k-rush/nixie/Nixie_Controller_BOM.xlsx

Sheet: Controller
Qty | Parts | Description | MANUFACTURER_NAME | MANUFACTURER_PART_NUMBER | Digikey PN | Digikey link | MOUSER_PART_NUMBER | MOUSER_PRICE-STOCK
2 | FTDI, SV2 | PIN HEADER | Preci-Dip | 801-87-005-10-005101 | 1212-1184-ND | https://www.digikey.com/product-detail/en/preci-dip/801-87-005-10-005101/1212-1184-ND/3757434
2 | C3, C4 | CAPACITOR, American symbol | AVX Corporation | SR215C103KAATR1 | 478-11035-1-ND | https://www.digikey.com/product-detail/en/avx-corporation/SR215C103KAATR1/478-11035-1-ND/7536147
1 | C5 | POLARIZED CAPACITOR, American symbol | Würth Elektronik | 860020672001- | 732-8847-3-ND | https://www.digikey.com/product-detail/en/w-rth-elektronik/860020672001/732-8847-3-ND/5727084
1 | RSENSE | RESISTOR, European symbol | Panasonic | ERJ-L1WKF50MU | P50MCT-ND | https://www.digikey.com/product-detail/en/panasonic-electronic-components/ERJ-L1WKF50MU/P50MCT-ND/272513
2 | C9, C11 | CAPACITOR, European symbol | AVX Corporation | 08055G104ZAT2A | 478-1421-1-ND | https://www.digikey.com/product-detail/en/avx-corporation/08055G104ZAT2A/478-1421-1-ND/564453
1 | C13 |  | Panasonic | ECW-U2104V16 | PCF1412CT-ND | https://www.digikey.com/product-detail/en/panasonic-electronic-components/ECW-U2104V16/PCF1412CT-ND/431748
1 | C10 | Capacitor, Tantalum, EU 7343 case, polarised | AVX Corporation | TPSD106K035R0300 | 478-1775-1-ND | https://www.digikey.com/product-detail/en/avx-corporation/TPSD106K035R0300/478-1775-1-ND/564807
1 | L1 | SMT power inductors | TDK Electronics Inc. | B82479A1104M000 | 495-2703-1-ND | https://www.digikey.com/product-detail/en/tdk-electronics-inc/B82479A1104M000/495-2703-1-ND/1243644
1 | R10 | RESISTOR, European symbol | Yageo | AC0805FR-0710KL | 311-10KLGCT-ND | https://www.digikey.com/product-detail/en/yageo/AC0805FR-0710KL/311-10KLGCT-ND/2828155
1 | R11 | RESISTOR, American symbol | Yageo | AC0805FR-0710KL | 311-10KLGCT-ND | https://www.digikey.com/product-detail/en/yageo/AC0805FR-0710KL/311-10KLGCT-ND/2828156
6 | R3, R4, R5, R6, R7, R8 | RESISTOR, American symbol | Vishay BC Components | MBB02070C1002FRP00 | BC10.0KZTR-ND | https://www.digikey.com/product-detail/en/vishay-bc-components/MBB02070C1002FRP00/BC10.0KZTR-ND/338172
1 | C14 | Capacitor, Tantalum, EU 7343 case, polarised | AVX Corporation | TPSD107M020R0085 | 478-6066-1-ND | https://www.digikey.com/product-detail/en/avx-corporation/TPSD107M020R0085/478-6066-1-ND/2208975
2 | C1, C2 | POLARIZED CAPACITOR, American symbol | Panasonic | ECE-A1HKA100I | P19476TB-ND | https://www.digikey.com/product-detail/en/panasonic-electronic-components/ECE-A1HKA100I/P19476TB-ND/6362773
1 | Q1 | CRYSTAL | ECS Inc. | ECS-160-20-4X-DU | XC1925-ND | https://www.digikey.com/product-detail/en/ECS-160-20-4X-DU/XC1925-ND/2781930/?itemSeq=315959394
1 | R9 | RESISTOR, European symbol | Panasonic | ERJ-1TYJ155U | PT1.5MXCT-ND | https://www.digikey.com/product-detail/en/panasonic-electronic-components/ERJ-1TYJ155U/PT1.5MXCT-ND/365327
1 | C8 | POLARIZED CAPACITOR, American symbol | Würth Elektronik | 860020672005- | 732-8851-1-ND | https://www.digikey.com/product-detail/en/w-rth-elektronik/860020672005/732-8851-1-ND/5728796
2 | R1, R2 | RESISTOR, American symbol | Vishay BC Components | MBB02070C2201FCT00 | BC3668CT-ND | https://www.digikey.com/product-detail/en/vishay-bc-components/MBB02070C2201FCT00/BC3668CT-ND/7351098
2 | C6, C7 | CAPACITOR, American symbol | AVX Corporation | SR211A200JAR | 478-11707-ND | https://www.digikey.com/product-detail/en/avx-corporation/SR211A200JAR/478-11707-ND/3065643
1 | X1 | .100 (2.54mm) Center Header - 2 Pin" | Preci-Dip | 801-87-002-10-001101 | 1212-1179-ND | https://www.digikey.com/product-detail/en/preci-dip/801-87-002-10-001101/1212-1179-ND/3757429
1 | Y2 | 32.768kHz Crystal | EPSON | C-002RX 32.7680K-E:PBFREE | SER3205-ND | https://www.digikey.com/product-detail/en/C-002RX+32.7680K-E%3aPBFREE/SER3205-ND/1022093/?itemSeq=315961191
1 | U1 | Atmel 328P | Microchip Technology | ATMEGA328P-PU | ATMEGA328P-PU-ND | https://www.digikey.com/product-detail/en/microchip-technology/ATMEGA328P-PU/ATMEGA328P-PU-ND/1914589
1 | C12 | Capacitor, Tantalum, EU 7343 case, polarised | Panasonic Electronic Components | EEV-EB2E100Q | PCE3432CT-ND | https://www.digikey.com/product-detail/en/panasonic-electronic-components/EEV-EB2E100Q/PCE3432CT-ND/361774
1 | VR1 |  | Bourns Inc. | 3214W-1-502E | 3214W-502ECT-ND | https://www.digikey.com/product-detail/en/3214W-1-502E/3214W-502ECT-ND/248448/?itemSeq=315962998
1 | IC3 | Positive VOLTAGE REGULATOR | STMicroelectronics | L7805CV | 497-1443-5-ND | https://www.digikey.com/product-detail/en/stmicroelectronics/L7805CV/497-1443-5-ND/585964
1 | S2 | Toggle Switch SPDT On-None-On, 100 mA, PCB | NKK Switches | A12AV | 360-3741-ND | https://www.digikey.com/product-detail/en/nkk-switches/A12AV/360-3741-ND/1058571 | 633-A12AV | https://www.mouser.com/Search/Refine.aspx?Keyword=633-A12AV
1 | J1 | DC Power Connectors Power Jack/Connector 2.1mm x 5.5mm | CUI Devices | PJ-102A | CP-102A-ND | https://www.digikey.com/product-detail/en/cui-devices/PJ-102A/CP-102A-ND/275425
1 | IC1 | DS1307 | Maxim Integrated | DS1307+ | DS1307+-ND | https://www.digikey.com/product-detail/en/maxim-integrated/DS1307/DS1307-ND/956883
1 | D1 | DIODE | Vishay Semiconductor Diodes Division | ES2F-E3/52T | ES2F-E3/52TGITR-ND | https://www.digikey.com/products/en?keywords=ES2F-E3%2F52TGITR-ND%09
1 | U2 | BATTERY HOLDER COIN 20MM PC PIN | TE Connectivity AMP Connectors | 120591-1 | A99328-ND | https://www.digikey.com/product-detail/en/120591-1/A99328-ND/289426/?itemSeq=315972113
1 | T1 | N-CHANNEL MOS FET | Vishay Siliconix | IRF644PBF | IRF644PBF-ND | https://www.digikey.com/product-detail/en/vishay-siliconix/IRF644PBF/IRF644PBF-ND/812069
1 | IC2 |  | Maxim Integrated | MAX1771ESA+ | MAX1771ESA+-ND | https://www.digikey.com/product-detail/en/maxim-integrated/MAX1771ESA-/MAX1771ESA--ND/947783
1 | VR2 | Encoders 12PPR 24Detents 5V 2bit GrayCodeFlatted | Bourns | PEC09-2220F-S0012 | PEC09-2220F-S0012-ND | https://www.digikey.com/products/en?keywords=PEC09-2220F-S0012 | 652-PEC092220FS0012 | https://www.mouser.com/Search/Refine.aspx?Keyword=652-PEC092220FS0012

Sheet: Display IN14
Qty | Value | Device | Package | Parts | Description | MANUFACTURER_NAME | MANUFACTURER_PART_NUMBER | Digikey PN | Digikey link
4 |  | LED3MM | LED3MM | LED1, LED2, LED3, LED4 | LED BLUE CLEAR 3MM T/H | Inolux | INL-3AB30 | 1830-1005-ND | https://www.digikey.com/product-detail/en/inolux/INL-3AB30/1830-1005-ND/7604618
1 |  | MA05-1 | MA05-1 | SV1 | PIN HEADER | Preci-Dip | 801-87-005-10-005101 | 1212-1184-ND | https://www.digikey.com/product-detail/en/preci-dip/801-87-005-10-005101/1212-1184-ND/3757434
4 | 15k | R-US_R0805 | R0805 | R3, R4, R5, R6 | RESISTOR, American symbol | Panasonic Electronic Components | ERJ-P06J153V | P15KADCT-ND | https://www.digikey.com/product-detail/en/panasonic-electronic-components/ERJ-P06J153V/P15KADCT-ND/525459
1 | 22-23-2021 | 22-23-2021 | 22-23-2021 | X1 | .100 (2.54mm) Center Header - 2 Pin" | Preci-Dip | 801-87-002-10-001101 | 1212-1179-ND | https://www.digikey.com/product-detail/en/preci-dip/801-87-002-10-001101/1212-1179-ND/3757429
1 | 330 | R-US_R0805 | R0805 | R1 | RESISTOR, American symbol | TE Connectivity Passive Product | CRGCQ0805F330R | A129743CT-ND | https://www.digikey.com/product-detail/en/te-connectivity-passive-product/CRGCQ0805F330R/A129743CT-ND/8577575
1 | 68k | R-US_R0805 | R0805 | R2 | RESISTOR, American symbol | Panasonic Electronic Components | ERJ-PB6B6802V | P20803CT-ND | https://www.digikey.com/product-detail/en/panasonic-electronic-components/ERJ-PB6B6802V/P20803CT-ND/6215058
4 | IN-14 | IN-14 | IN-14 | N1, N2, N3, N4 | IN-14: medium numeric frontview nixie tube
1 | IN-3 | IN-3 | IN-3 | N5 | IN-3: nixie bulb
5 | TPIC6B595DWRG4 | TPIC6B595DWRG4 | DW20 | U1, U2, U3, U4, U5 |  | Texas Instruments | TPIC6B595DWRG4 | 296-26898-1-ND | https://www.digikey.com/product-detail/en/texas-instruments/TPIC6B595DWRG4/296-26898-1-ND/2255207
