k-rush/nixie/(list of files, cad)

Other CAD files:
Fusion/Nixie_Controller.f3d
