k-rush/nixie/Nixie_Contoller/nixie_controller.brd

## EAGLE design Nixie_Contoller/nixie_controller.brd (2020-02-24)

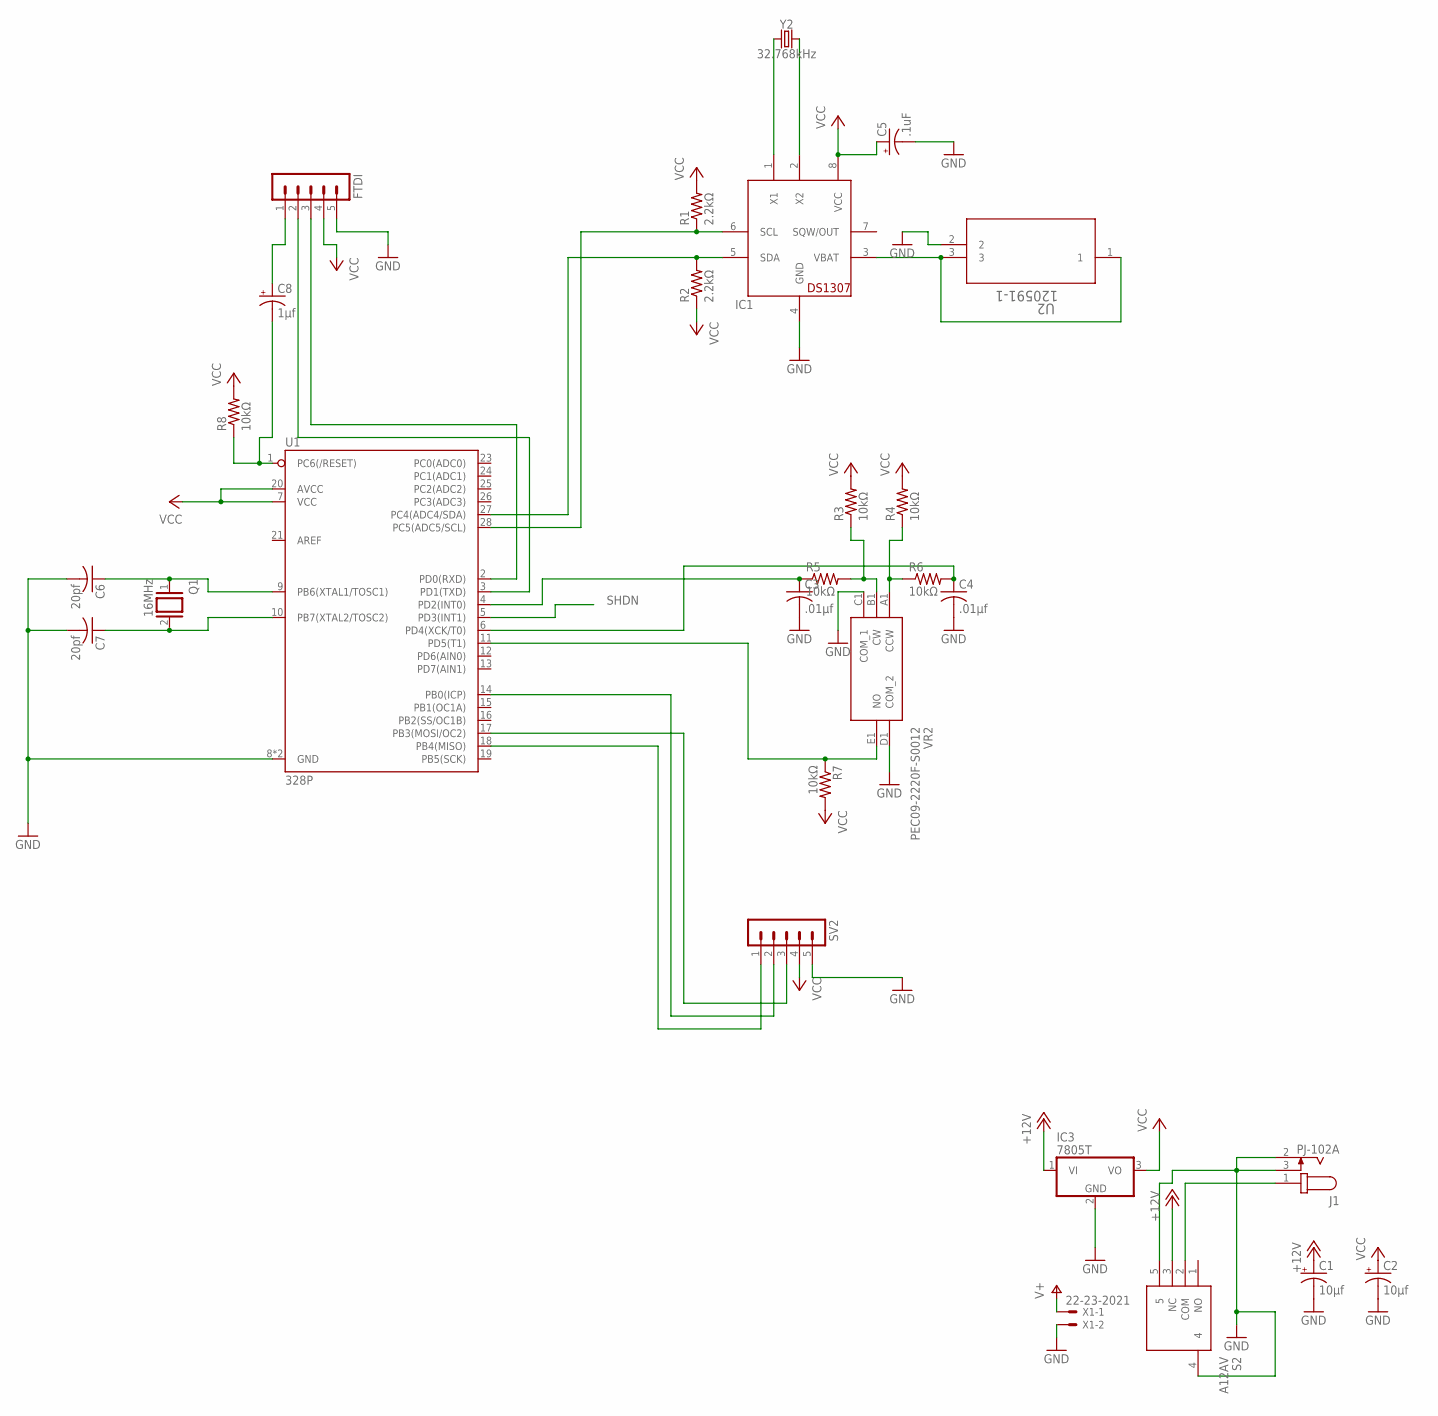
[picture p1: schematic nixie_controller.sch, sheet 1]

Parts:
C1, C2: 10μf; E2-5
C3, C4: .01μf; C050-030X075
C5: .1uF; E2-5
C6, C7: 20pf; C050-030X075
C8: 1μf; E2-5
FTDI: MA05-1
IC1: DS1307; DIL08
IC3: 7805T; TO220H
J1: PJ-102A; CUI_PJ-102A
Q1: 16MHz; QS
R1, R2: 2.2kΩ; 0207/10
R3, R4, R5, R6, R7, R8: 10kΩ; 0207/10
S2: A12AV
SV2: MA05-1
U1: 328P; DIP28
U2: 120591-1; CONN3_120591-1
VR2: PEC09-2220F-S0012; PEC092220FS0012
X1: 22-23-2021
Y2: 32.768kHz; CRYSTAL-PTH-2X6-CYL

Connections:
+12V: C1.+, IC3.1 (VI), S2.3 (NC); also elsewhere on the board
CLK: SV2.1, U1.18 (PB4(MISO))
GND: C1.-, C2.-, C3.2, C4.2, C5.-, C6.2, C7.2, FTDI.5, IC1.4 (GND), IC3.2 (GND), J1.2, J1.3, S2.4, S2.5, SV2.5, U1.8 (GND), U1.22 (GND), U2.2, VR2.C1 (COM_1), VR2.D1 (COM_2), X1.2; also elsewhere on the board
unnamed: IC1.3 (VBAT), U2.1, U2.3
unnamed: R7.1, U1.11 (PD5(T1)), VR2.E1 (NO)
unnamed: R4.1, R6.1, VR2.A1 (CCW)
unnamed: IC1.1 (X1), Y2.1
unnamed: IC1.2 (X2), Y2.2
unnamed: J1.1, S2.2 (COM)
unnamed: SV2.2, U1.14 (PB0(ICP))
unnamed: C3.1, R5.1, U1.4 (PD2(INT0))
unnamed: C4.1, R6.2, U1.6 (PD4(XCK/T0))
unnamed: C6.1, Q1.1, U1.9 (PB6(XTAL1/TOSC1))
unnamed: IC1.6 (SCL), R1.1, U1.28 (PC5(ADC5/SCL))
unnamed: IC1.5 (SDA), R2.2, U1.27 (PC4(ADC4/SDA))
unnamed: C8.-, R8.1, U1.1 (PC6(/RESET))
unnamed: R3.1, R5.2, VR2.B1 (CW)
unnamed: C7.1, Q1.2, U1.10 (PB7(XTAL2/TOSC2))
unnamed: C8.+, FTDI.1
unnamed: SV2.3, U1.17 (PB3(MOSI/OC2))
unnamed: FTDI.2, U1.3 (PD1(TXD))
unnamed: FTDI.3, U1.2 (PD0(RXD))
SHDN: U1.5 (PD3(INT1)); also elsewhere on the board
V+: X1.1; also elsewhere on the board
VCC: C2.+, C5.+, FTDI.4, IC1.8 (VCC), IC3.3 (VO), R1.2, R2.1, R3.2, R4.2, R7.2, R8.2, SV2.4, U1.7 (VCC), U1.20 (AVCC)

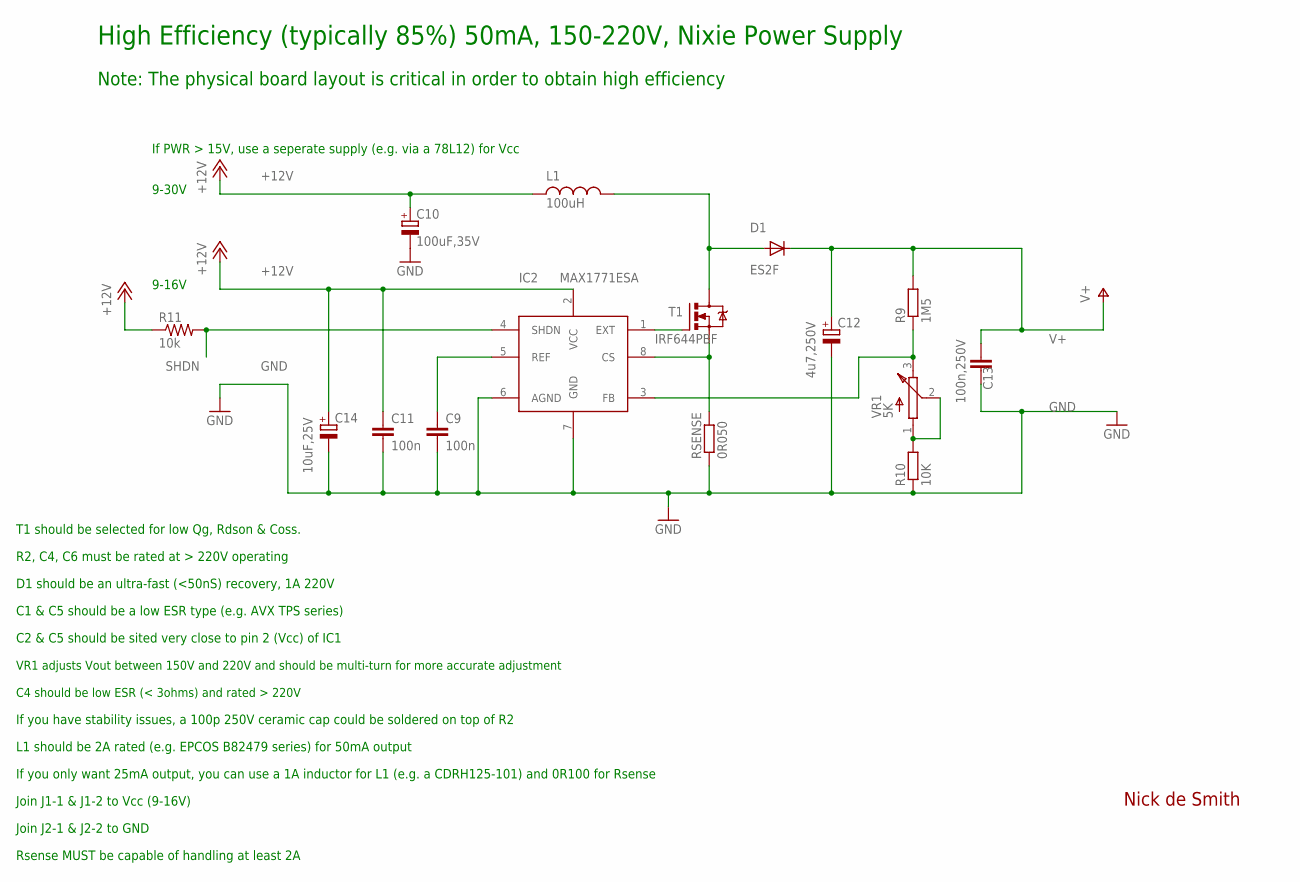
[picture p2: schematic nixie_controller.sch, sheet 2]

Parts:
C9, C11: 100n; C0805
C10: 100uF,35V; C-EIA-7343
C12: 4u7,250V; NICHICON-UJ-12
C13: 100n,250V; C2420
C14: 10uF,25V; C-EIA-7343
D1: ES2F; SMC
IC2: MAX1771ESA; SO-8
L1: 100uH; L-B82479
R9: 1M5; R2512
R10: 10K; R0805
R11: 10k; M0805
RSENSE: 0R050; R2010
T1: IRF644PBF; TO220BV
VR1: 5K; BOURNS-3214W

Connections:
+12V: C10.+, C11.1, C14.+, IC2.2 (VCC), L1.P$1 (1), R11.1; also elsewhere on the board
EXT: IC2.1 (EXT), T1.G
GND: C9.2, C10.-, C11.2, C12.1 (-), C13.P$2 (2), C14.-, IC2.6 (AGND), IC2.7 (GND), R10.1, RSENSE.1; also elsewhere on the board
unnamed: IC2.3 (FB), R9.1, VR1.3 (B)
unnamed: D1.A, L1.P$2 (2), T1.D
unnamed: C9.1, IC2.5 (REF)
unnamed: R10.2, VR1.1 (A), VR1.2 (W)
unnamed: IC2.8 (CS), RSENSE.2, T1.S
SHDN: IC2.4 (SHDN), R11.2; also elsewhere on the board
V+: C12.2 (+), C13.P$1 (1), D1.C, R9.2; also elsewhere on the board

Notes on the sheet:
R2, C4, C6 must be rated at > 220V operating
D1 should be an ultra-fast (<50nS) recovery, 1A 220V
C1 & C5 should be a low ESR type (e.g. AVX TPS series)
C2 & C5 should be sited very close to pin 2 (Vcc) of IC1
Nick de Smith
VR1 adjusts Vout between 150V and 220V and should be multi-turn for more accurate adjustment
C4 should be low ESR (< 3ohms) and rated > 220V
If you have stability issues, a 100p 250V ceramic cap could be soldered on top of R2
L1 should be 2A rated (e.g. EPCOS B82479 series) for 50mA output
Join J1-1 & J1-2 to Vcc (9-16V)
Join J2-1 & J2-2 to GND
T1 should be selected for low Qg, Rdson & Coss.
Rsense MUST be capable of handling at least 2A
High Efficiency (typically 85%) 50mA, 150-220V, Nixie Power Supply
9-16V
9-30V
If PWR > 15V, use a seperate supply (e.g. via a 78L12) for Vcc
Note: The physical board layout is critical in order to obtain high efficiency
If you only want 25mA output, you can use a 1A inductor for L1 (e.g. a CDRH125-101) and 0R100 for Rsense

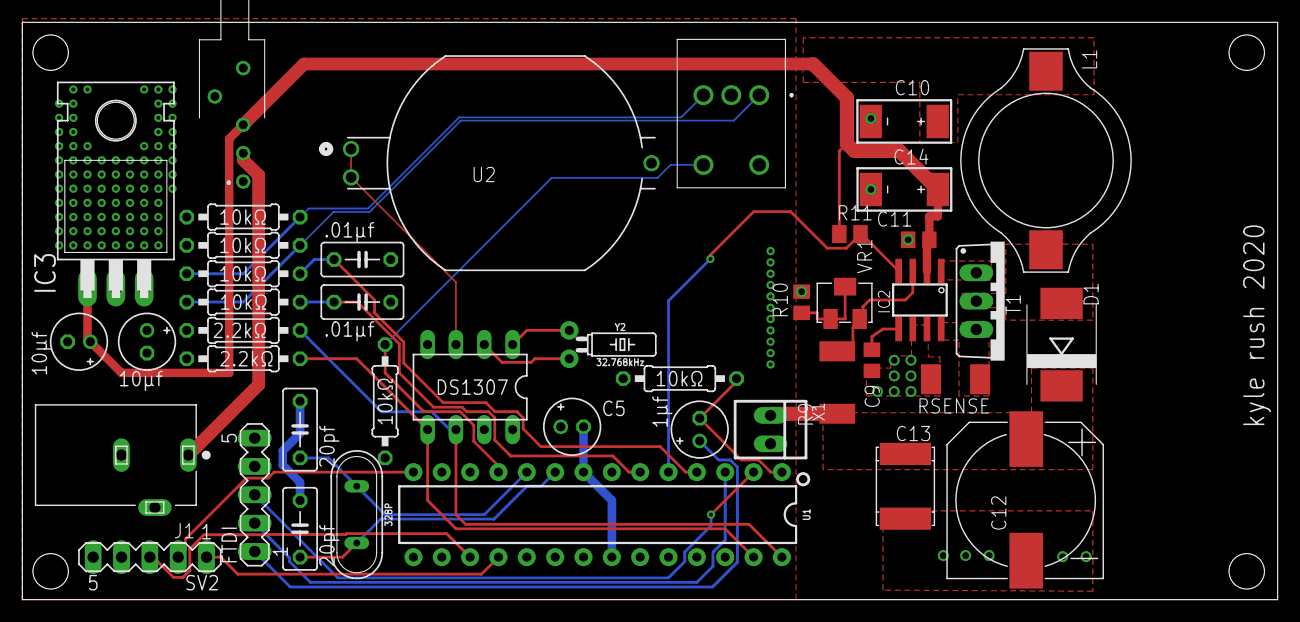
[picture p3: board nixie_controller.brd from above]

Board: 2 copper layers, 112.5 x 51.7 mm, 43 parts (0 on the bottom side), 31 nets.
