k-rush/nixie/Nixie Display IN-14/display.brd

## EAGLE design Nixie Display IN-14/display.brd (2020-02-12)

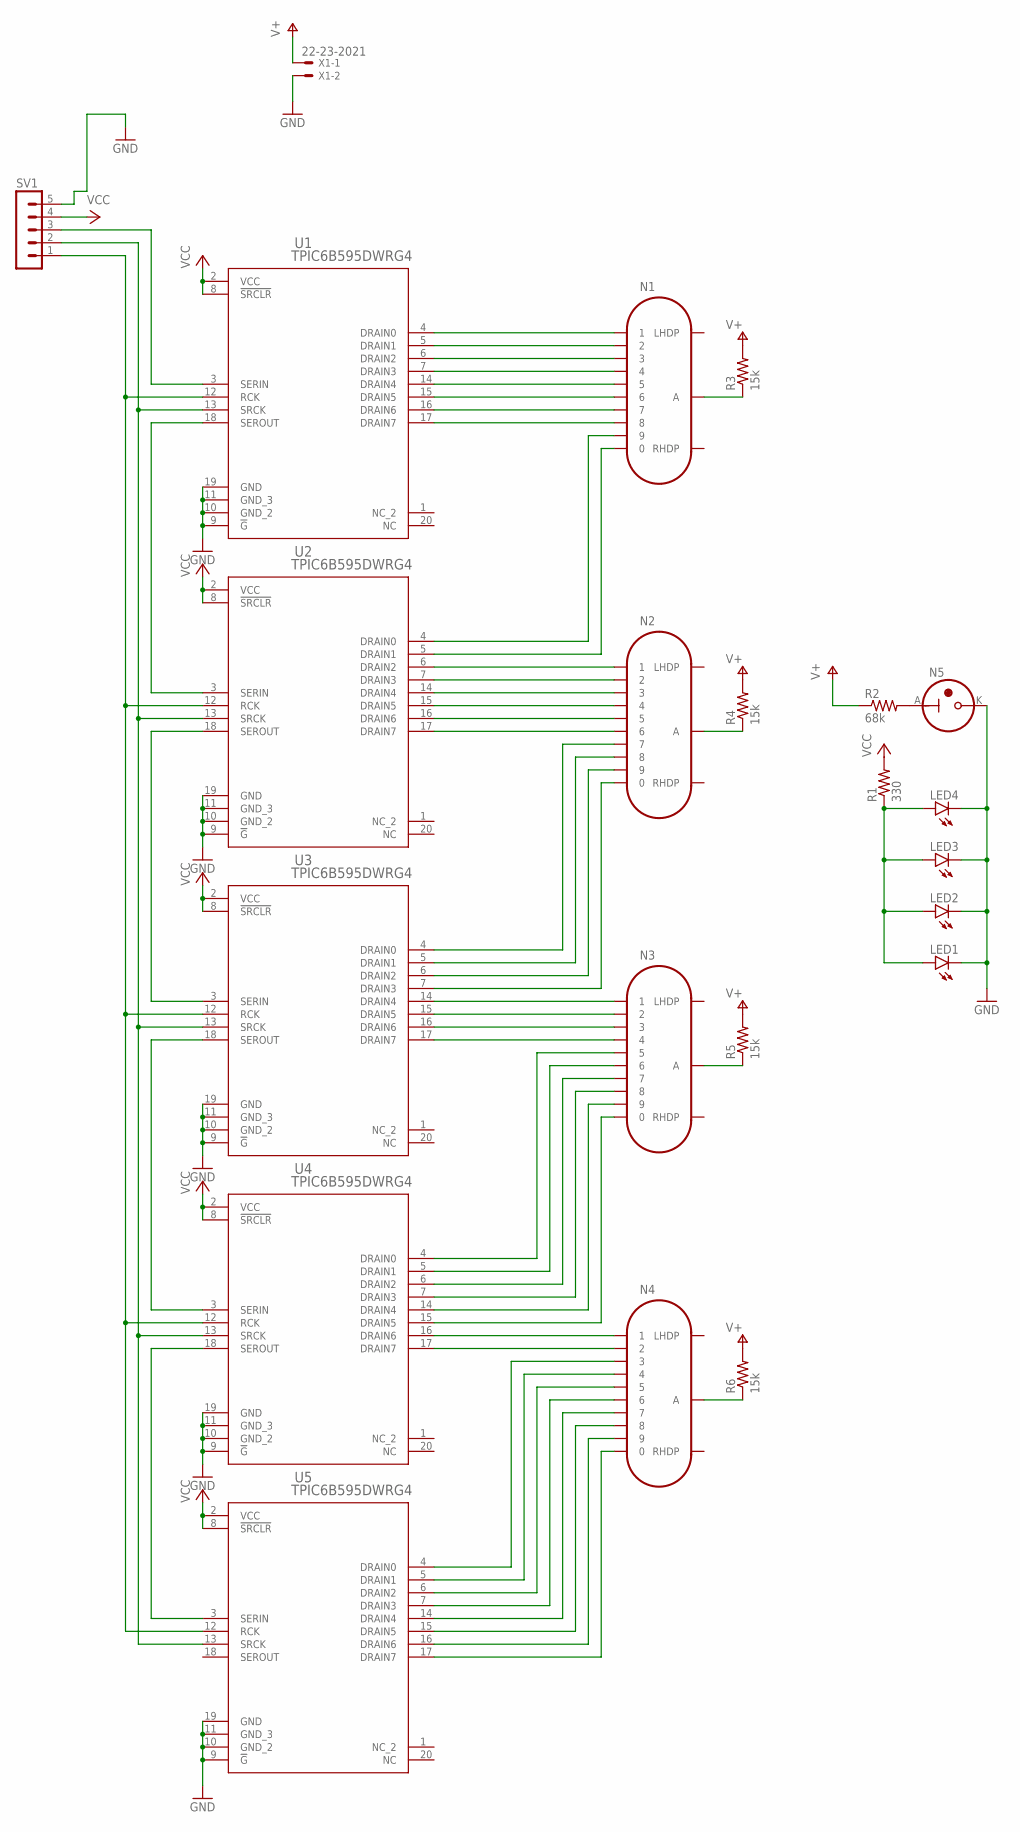
[picture p4: schematic display.sch, sheet 1]

Parts:
LED1, LED2, LED3, LED4: LED3MM
N1, N2, N3, N4: IN-14
N5: IN-3
R1: 330; R0805
R2: 68k; R0805
R3, R4, R5, R6: 15k; R0805
SV1: MA05-1
U1, U2, U3, U4, U5: TPIC6B595DWRG4; DW20
X1: 22-23-2021

Connections:
GND: LED1.K (C), LED2.K (C), LED3.K (C), LED4.K (C), N5.K, SV1.5, U1.9 (!G), U1.10 (GND_2), U1.11 (GND_3), U1.19 (GND), U2.9 (!G), U2.10 (GND_2), U2.11 (GND_3), U2.19 (GND), U3.9 (!G), U3.10 (GND_2), U3.11 (GND_3), U3.19 (GND), U4.9 (!G), U4.10 (GND_2), U4.11 (GND_3), U4.19 (GND), U5.9 (!G), U5.10 (GND_2), U5.11 (GND_3), U5.19 (GND), X1.2
unnamed: N1.1, U1.4 (DRAIN0)
unnamed: N1.2, U1.5 (DRAIN1)
unnamed: N1.3, U1.6 (DRAIN2)
unnamed: N1.4, U1.7 (DRAIN3)
unnamed: N1.5, U1.14 (DRAIN4)
unnamed: N1.6, U1.15 (DRAIN5)
unnamed: N1.7, U1.16 (DRAIN6)
unnamed: N1.8, U1.17 (DRAIN7)
unnamed: N1.9, U2.4 (DRAIN0)
unnamed: N1.0, U2.5 (DRAIN1)
unnamed: N2.1, U2.6 (DRAIN2)
unnamed: N2.2, U2.7 (DRAIN3)
unnamed: N2.3, U2.14 (DRAIN4)
unnamed: N2.4, U2.15 (DRAIN5)
unnamed: N2.5, U2.16 (DRAIN6)
unnamed: N2.6, U2.17 (DRAIN7)
unnamed: N2.7, U3.4 (DRAIN0)
unnamed: N2.8, U3.5 (DRAIN1)
unnamed: N2.9, U3.6 (DRAIN2)
unnamed: N2.0, U3.7 (DRAIN3)
unnamed: LED1.A, LED2.A, LED3.A, LED4.A, R1.1
unnamed: N5.A, R2.2
unnamed: N1.A, R3.1
unnamed: N2.A, R4.1
unnamed: N3.A, R5.1
unnamed: N4.A, R6.1
unnamed: U4.18 (SEROUT), U5.3 (SERIN)
unnamed: SV1.1, U1.12 (RCK), U2.12 (RCK), U3.12 (RCK), U4.12 (RCK), U5.12 (RCK)
unnamed: N3.1, U3.14 (DRAIN4)
unnamed: N3.2, U3.15 (DRAIN5)
unnamed: N3.3, U3.16 (DRAIN6)
unnamed: N3.4, U3.17 (DRAIN7)
unnamed: N3.8, U4.7 (DRAIN3)
unnamed: N3.6, U4.5 (DRAIN1)
unnamed: N3.9, U4.14 (DRAIN4)
unnamed: N3.5, U4.4 (DRAIN0)
unnamed: N3.7, U4.6 (DRAIN2)
unnamed: N3.0, U4.15 (DRAIN5)
unnamed: N4.1, U4.16 (DRAIN6)
unnamed: N4.2, U4.17 (DRAIN7)
unnamed: N4.0, U5.17 (DRAIN7)
unnamed: N4.9, U5.16 (DRAIN6)
unnamed: N4.8, U5.15 (DRAIN5)
unnamed: N4.7, U5.14 (DRAIN4)
unnamed: N4.6, U5.7 (DRAIN3)
unnamed: N4.5, U5.6 (DRAIN2)
unnamed: N4.4, U5.5 (DRAIN1)
unnamed: N4.3, U5.4 (DRAIN0)
unnamed: SV1.2, U1.13 (SRCK), U2.13 (SRCK), U3.13 (SRCK), U4.13 (SRCK), U5.13 (SRCK)
unnamed: SV1.3, U1.3 (SERIN)
unnamed: U1.18 (SEROUT), U2.3 (SERIN)
unnamed: U2.18 (SEROUT), U3.3 (SERIN)
unnamed: U3.18 (SEROUT), U4.3 (SERIN)
V+: R2.1, R3.2, R4.2, R5.2, R6.2, X1.1
VCC: R1.2, SV1.4, U1.2 (VCC), U1.8 (!SRCLR), U2.2 (VCC), U2.8 (!SRCLR), U3.2 (VCC), U3.8 (!SRCLR), U4.2 (VCC), U4.8 (!SRCLR), U5.2 (VCC), U5.8 (!SRCLR)

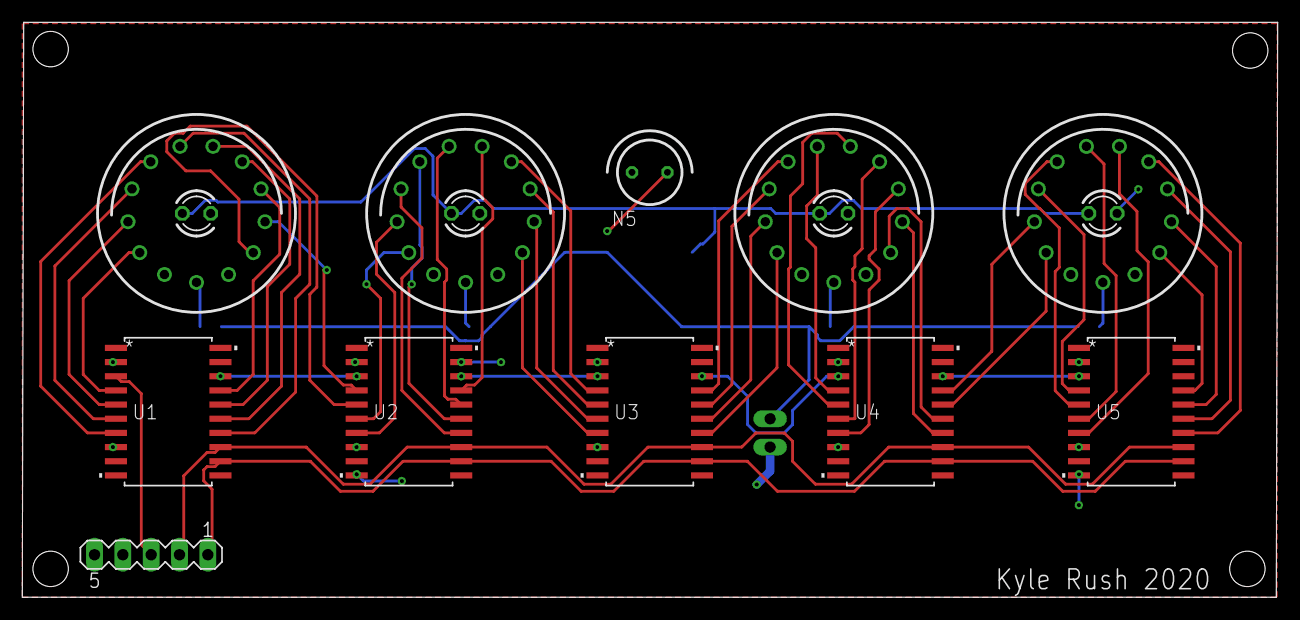
[picture p5: board display.brd from above]

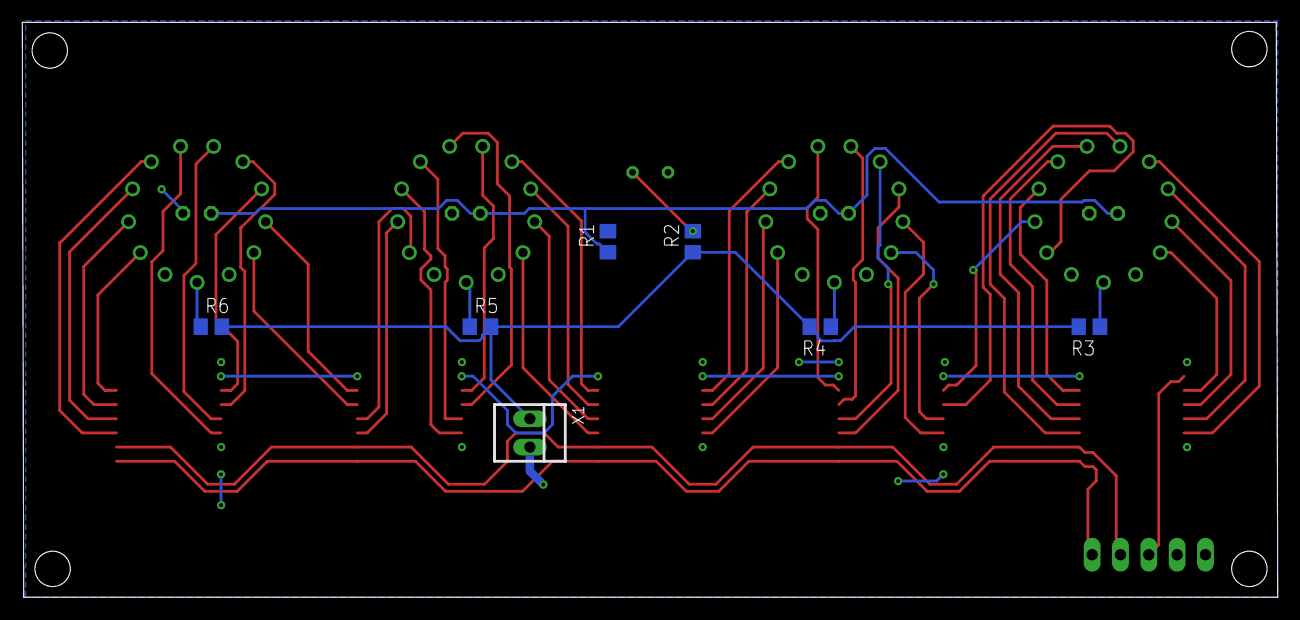
[picture p6: board display.brd from below]

Board: 2 copper layers, 112.6 x 51.6 mm, 22 parts (7 on the bottom side), 56 nets.
