k-rush/nixie/Arduino_Barebones/Barebones_328p.brd

## EAGLE design Arduino_Barebones/Barebones_328p.brd (2019-12-31)

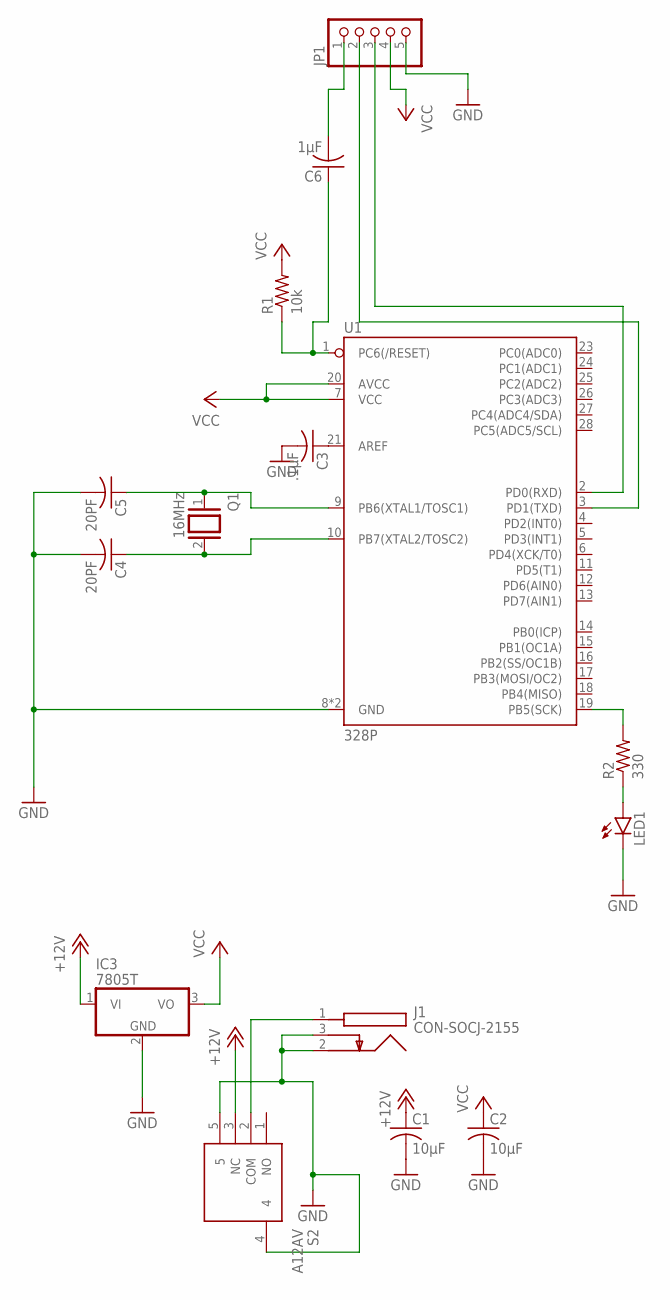
[picture p7: schematic Barebones_328p.sch]

Parts:
C1, C2: 10μF; C0603
C3: .1μF; C0603
C4, C5: 20PF; C0603
C6: 1μF; C0603
IC3: 7805T; TO220H
J1: CON-SOCJ-2155; CONSOCJ2155
JP1: PINHD-1X5; 1X05
LED1: LEDCHIP-LED0805; CHIP-LED0805
Q1: 16MHz; QS
R1: 10k; R0603
R2: 330; R0603
S2: A12AV
U1: 328P; DIP28

Connections:
+12V: C1.1, IC3.1 (VI), S2.3 (NC)
GND: C1.2, C2.2, C3.2, C4.2, C5.2, IC3.2 (GND), J1.2, J1.3, JP1.5, LED1.C, S2.4, S2.5, U1.8 (GND), U1.22 (GND)
unnamed: R2.2, U1.19 (PB5(SCK))
unnamed: LED1.A, R2.1
unnamed: J1.1, S2.2 (COM)
unnamed: C3.1, U1.21 (AREF)
unnamed: C5.1, Q1.1, U1.9 (PB6(XTAL1/TOSC1))
unnamed: C6.1, R1.1, U1.1 (PC6(/RESET))
unnamed: C4.1, Q1.2, U1.10 (PB7(XTAL2/TOSC2))
unnamed: C6.2, JP1.1
unnamed: JP1.2, U1.3 (PD1(TXD))
unnamed: JP1.3, U1.2 (PD0(RXD))
VCC: C2.1, IC3.3 (VO), JP1.4, R1.2, U1.7 (VCC), U1.20 (AVCC)

Board: 2 copper layers, 15 parts (0 on the bottom side), 13 nets, no tracks yet.
