k-rush/nixie/(commit log)

2019-12-19 Adds schematics
    [display.brd, display.sch, nixie_controller.brd, nixie_controller.sch]
2019-12-19 Changes to vertical mounted encoder and switch on base
    [nixie_controller.brd, nixie_controller.csv, nixie_controller.sch]
2019-12-19 small big fixes
    [nixie_controller.brd, nixie_controller.sch]
2019-12-24 Snapshot 12-23
    [nixie_controller.brd, nixie_controller.csv, nixie_controller.sch]
2019-12-26 Adds LV switching PSU
    [Nixie HV PSU MAX1771.brd, Nixie HV PSU MAX1771.sch, nixie_controller.brd, nixie_controller.csv, nixie_controller.sch]
2019-12-27 Revert "Adds LV switching PSU"
    This reverts commit 12f529c285d7cae732b9ac692bbbf0adcfd9615d.
    [Nixie HV PSU MAX1771.brd, Nixie HV PSU MAX1771.sch, nixie_controller.brd, nixie_controller.csv, nixie_controller.sch]
2019-12-31 Through hole, fixes HV PSU, all components
    [Barebones_328p.brd, Barebones_328p.sch, nixie_controller.brd]
2020-01-27 Stable PSU, TPIC6b595 working. Release candidate
    [display.brd, nixie_controller.brd, nixie_controller.sch]
2020-01-28 Updates parts to Digikey equivalent, adds BOM, adds SHDN to pin 5
    [Nixie_Controller_BOM.xlsx, nixie_controller.brd, nixie_controller.csv, nixie_controller.sch]
2020-01-28 Production ready board with BOMS
    [Nixie_Controller_BOM.xlsx, Nixie_Controller_Digikey_BOM.csv, display.brd, display.csv, display.sch, nixie_controller.brd]
2020-01-29 Adds IN12B Display board
    [display.brd, display.csv, display.sch]
2020-02-01 Begins sketch, fixes spacing and encoder circuit
    [display.brd]
2020-02-01 Reverts encoder change
2020-02-05 Tweaks design, adds arduino clock sketch
    [display.brd, display.csv, display.sch]
2020-02-12 Reverses polarity of IN3
    [display.brd, display.sch]
2020-02-24 Reconfigures controller, configures clock to pull sketch down SHDN pin
    [Nixie_Controller.f3d, nixie_controller.brd]
